TotoroTron/ANC_System/sources_1/new/i2s_controller.v

`timescale 1ns / 1ps
`default_nettype none
//////////////////////////////////////////////////////////////////////////////////
// Company: Digilent
// Engineer: Arthur Brown
// 
// Create Date: 03/23/2018 01:23:15 PM
// Module Name: axis_volume_controller
// Description: AXI-Stream volume controller intended for use with AXI Stream Pmod I2S2 controller.
//              Whenever a 2-word packet is received on the slave interface, it is multiplied by 
//              the value of the switches, taken to represent the range 0.0:1.0, then sent over the
//              master interface. Reception of data on the slave interface is halted while processing and
//              transfer is taking place.
// 
// Revision:
// Revision 0.01 - File Created
// Additional Comments:
// 
//////////////////////////////////////////////////////////////////////////////////

module i2s_controller (
    input wire clk,
    
    //AXIS SLAVE INTERFACE
    input  wire s_axis_valid,
    output reg  s_axis_ready = 1'b1,
    input  wire s_axis_last,
    
    // AXIS MASTER INTERFACE
    output reg m_axis_valid = 1'b0,
    input  wire m_axis_ready,
    output reg m_axis_last = 1'b0
);
    
    wire m_select = m_axis_last;
    wire m_new_word = (m_axis_valid == 1'b1 && m_axis_ready == 1'b1) ? 1'b1 : 1'b0;
    wire m_new_packet = (m_new_word == 1'b1 && m_axis_last == 1'b1) ? 1'b1 : 1'b0;
    
    wire s_select = s_axis_last;
    wire s_new_word = (s_axis_valid == 1'b1 && s_axis_ready == 1'b1) ? 1'b1 : 1'b0;
    wire s_new_packet = (s_new_word == 1'b1 && s_axis_last == 1'b1) ? 1'b1 : 1'b0;
    reg s_new_packet_r = 1'b0;
    
    always@(posedge clk) begin
        s_new_packet_r <= s_new_packet;
    end

    always@(posedge clk)
        if (s_new_packet_r == 1'b1)
            m_axis_valid <= 1'b1;
        else if (m_new_packet == 1'b1)
            m_axis_valid <= 1'b0;
            
    always@(posedge clk)
        if (m_new_packet == 1'b1)
            m_axis_last <= 1'b0;
        else if (m_new_word == 1'b1)
            m_axis_last <= 1'b1;
            
    always@(posedge clk)
        if (s_new_packet == 1'b1)
            s_axis_ready <= 1'b0;
        else if (m_new_packet == 1'b1)
            s_axis_ready <= 1'b1;
endmodule
