TotoroTron/ANC_System/sources_1/new/fsm_discrete_fir_filter.vhd

Library xpm;
use xpm.vcomponents.all;

LIBRARY IEEE;
USE IEEE.std_logic_1164.ALL;
USE IEEE.numeric_std.ALL;
USE work.anc_package.ALL;
use IEEE.NUMERIC_STD.ALL;

ENTITY Discrete_FIR_Filter_FSM IS
	GENERIC( L : integer := 128; W : integer := 8); -- L = length (filter order), W = width (parallel MACs)
	PORT(
		clk_anc 	: IN  std_logic; --10Khz ANC System Clock
		clk_dsp		: IN  std_logic; --125Mhz FPGA Clock Pin
		clk_ila     : in std_logic;
		reset 		: IN  std_logic;
        en   		: IN  std_logic;
        input 		: IN  std_logic_vector(23 DOWNTO 0); 
		output 		: out std_logic_vector(23 downto 0) := (others => '0');
		--RAM INTERFACE
		wt_addr 	: out std_logic_vector(5 downto 0) := (others => '0');
		wt_ram_en 	: out std_logic := '0';
		wt_wr_en	: out std_logic := '0';
		wt_data_in 	: in  vector_of_std_logic_vector24(0 to W-1)
	);
END Discrete_FIR_Filter_FSM;

ARCHITECTURE Behavioral OF Discrete_FIR_Filter_FSM IS
	CONSTANT R : integer := L/W; --length/width ratio
	TYPE STATE_TYPE IS (S0, S1, S2, S3, S4, R0, R1);
	SIGNAL STATE               : STATE_TYPE := S0;
	SIGNAL NEXT_STATE 	       : STATE_TYPE;
	SIGNAL input_signed 	   : signed(23 downto 0) := (others => '0');
	SIGNAL s_addr			   : unsigned(5 downto 0) := (others => '0');
	signal s_next_addr         : unsigned(5 downto 0) := (others => '0');
	SIGNAL idle                : std_logic := '1';
	signal next_idle           : std_logic := '1';
	signal s_sum               : signed(52 downto 0) := (others => '0');
	signal s_next_sum          : signed(52 downto 0) := (others => '0');
	
    signal sample_reg           : vector_of_signed24(0 to W-1) := (others => (others => '0'));
    signal next_sample_reg      : vector_of_signed24(0 to W-1) := (others => (others => '0'));
    signal sa_addr 		        :  std_logic_vector(5 downto 0) := (others => '0');
    signal sa_ram_en		    :  std_logic := '0'; --ram clk enable
    signal sa_wr_en 		    :  std_logic_vector(0 downto 0) := "0"; --ram write enable
    signal sa_data_in           : vector_of_std_logic_vector24(0 to W-1) := (others => (others => '0'));
    signal sa_data_out          : vector_of_std_logic_vector24(0 to W-1) := (others => (others => '0'));
    
    signal dbiterra 		: 	std_logic := '0';
	signal sbiterra 		:	std_logic := '0';
	signal ena 				:	std_logic := '0';
	signal injectdbiterra	:	std_logic := '0';
	signal injectsbiterra 	:	std_logic := '0';
	signal regcea 			:	std_logic := '0';
	signal sleep 			:	std_logic := '0';
	
	signal ila_addr : std_logic_vector(23 downto 0);
BEGIN

	input_signed <= signed(input);
	wt_addr <= std_logic_vector(s_addr);
	sa_addr <= std_logic_vector(s_addr);
	ila_addr <= X"0000" & "00" & sa_addr;
	
--    ILA_FIR_FILTER : ila_3
--	port map(
--	   clk => clk_dsp,
--	   probe0 => ila_addr,
--	   probe1 => wt_data_in(0),
--	   probe2 => wt_data_in(1),
--	   probe3 => wt_data_in(2),
--	   probe4 => sa_data_in(0),
--	   probe5 => sa_data_in(1),
--	   probe6 => sa_data_in(2)
--	);

	DSP_STATE_REGISTER : PROCESS(clk_dsp, reset, en)
	BEGIN
	IF rising_edge(clk_dsp) THEN
		IF reset = '1' THEN
			STATE <= R0;
			idle <= '1';
			s_addr <= (others => '0');
			sample_reg <= (others => (others => '0'));
		ELSIF en = '1' THEN
			STATE <= NEXT_STATE;
			idle <= next_idle;
			s_addr <= s_next_addr;
			s_sum <= s_next_sum;
			sample_reg <= next_sample_reg;
		END IF;
	END IF;
	END PROCESS;
	
    DSP_STATE_MACHINE : PROCESS(STATE, clk_anc, idle, s_addr, wt_data_in, input_signed, sample_reg)
        variable weight_in 	    : vector_of_signed24(0 to W-1) := (others => (others => '0'));
        variable sample_in      : vector_of_signed24(0 to W-1) := (others => (others => '0'));
        variable sample_out     : vector_of_signed24(0 to W-1) := (others => (others => '0'));
        variable mult			: vector_of_signed48(0 to W-1) := (others => (others => '0'));
        variable mult_cast	    : vector_of_signed53(0 to W-1) := (others => (others => '0'));
        variable mux1_out       : vector_of_signed24(0 to W-1) := (others => (others => '0'));
        variable mux2_out       : vector_of_signed24(0 to W-1) := (others => (others => '0'));
        variable accumulator	: signed(52 downto 0) := (others => '0');
    BEGIN
        next_idle       <= idle;
        s_next_addr     <= s_addr;
        s_next_sum      <= s_sum;
        next_sample_reg <= sample_reg;
        weight_in       := (others => (others => '0'));
        mult            := (others => (others => '0'));
        mult_cast       := (others => (others => '0'));
        accumulator     := (others => '0');
        sample_in       := (others => (others => '0'));
        sample_out      := (others => (others => '0'));
        mux1_out        := (others => (others => '0'));
        mux2_out        := (others => (others => '0'));
        
        CASE STATE IS
        WHEN S0 => --initial state
            wt_ram_en <= '0'; wt_wr_en <= '0';
            sa_ram_en <= '0'; sa_wr_en <= "0"; 
            s_next_addr <= (others => '0');
            NEXT_STATE <= S0;
            IF CLK_ANC = '1' THEN
                NEXT_IDLE <= '1';
            ELSIF CLK_ANC = '0' AND IDLE = '1' THEN
                s_next_sum <= (others => '0');
                NEXT_IDLE <= '0';
                NEXT_STATE <= S1;
            END IF; 
        WHEN S1 => --initiate read from memory (read latency = 1)
            wt_ram_en <= '1'; wt_wr_en <= '0';
            sa_ram_en <= '1'; sa_wr_en <= "0"; 
            NEXT_STATE <= S2; --S2
        WHEN S2 => --wait for read latency
            wt_ram_en <= '0'; wt_wr_en <= '0';
            sa_ram_en <= '0'; sa_wr_en <= "0"; 
            NEXT_STATE <= S3;
        WHEN S3 => --data from memory clocked-in
            wt_ram_en <= '0'; wt_wr_en <= '0';
            sa_ram_en <= '1'; sa_wr_en <= "1"; 
            accumulator := s_sum;
            
            for i in 0 to W-1 loop
                weight_in(i) := signed(wt_data_in(i));
                sample_in(i) := signed(sa_data_in(i));
                
                if i = 0 then
                    if s_addr = 0 then
                    mux1_out(i) := input_signed; else
                    mux1_out(i) := sample_in(i); end if;
                else
                    if s_addr = R-1 then
                    mux1_out(i) := sample_reg(i-1); else
                    mux1_out(i) := sample_in(i); end if;
                end if;
                
                next_sample_reg(i) <= mux1_out(i);
                sample_out(i) := sample_reg(i);
                sa_data_out(i) <= std_logic_vector(sample_out(i)(23 downto 0));
                
                if i = 0 then
                    if s_addr = 0 then
                    mux2_out(i) := input_signed; else
                    mux2_out(i) := sample_in(i); end if;
                else
                    mux2_out(i) := sample_in(i);
                end if;
                
                mult(i) := weight_in(i) * mux2_out(i);
                mult_cast(i) := resize(mult(i), 53);
                accumulator := accumulator + mult_cast(i); --cascading adder risks timing failure
            end loop; --find a way to for-loop a balanced adder tree

            s_next_sum <= accumulator;
            
            NEXT_STATE <= S4;
        WHEN S4 => --increment address
            wt_ram_en <= '0'; wt_wr_en <= '0';
            sa_ram_en <= '0'; sa_wr_en <= "0"; 
            IF s_addr < R-1 THEN
                s_next_addr <= s_addr + 1;
                NEXT_STATE <= S1;
            ELSIF s_addr = R-1 THEN
                output <= std_logic_vector(s_sum(47 downto 24));
                NEXT_STATE <= S0;
            END IF;
        WHEN R0 => --flush RAM with zeros
            wt_ram_en <= '0'; wt_wr_en <= '0';
            sa_ram_en <= '1'; sa_wr_en <= "1"; 
            sa_data_out <= (others => (others => '0'));
            output <= (others => '0');
            NEXT_STATE <= R1;
        WHEN R1 =>
            wt_ram_en <= '0'; wt_wr_en <= '0';
            sa_ram_en <= '0'; sa_wr_en <= "0"; 
            IF s_addr < R-1 THEN
                s_next_addr <= s_addr + 1;
                NEXT_STATE <= R0;
            ELSIF s_addr = R-1 THEN
                NEXT_STATE <= S0;
            END IF;
        END CASE;
        
    END PROCESS;
    
    -- xpm_memory_spram: Single Port RAM
    -- Xilinx Parameterized Macro, version 2019.2
    INPUT_BUFFER_STORAGE : for i in 0 to W-1 generate
    xpm_memory_spram_inst0 : xpm_memory_spram
        generic map (
        ADDR_WIDTH_A => 6, -- DECIMAL
        AUTO_SLEEP_TIME => 0, -- DECIMAL
        BYTE_WRITE_WIDTH_A => 24, -- DECIMAL
        CASCADE_HEIGHT => 0, -- DECIMAL
        ECC_MODE => "no_ecc", -- String
        MEMORY_INIT_FILE => "none", -- String
        MEMORY_INIT_PARAM => "0", -- String
        MEMORY_OPTIMIZATION => "true", -- String
        MEMORY_PRIMITIVE => "auto", -- String
        MEMORY_SIZE => 1536, -- DECIMAL
        MESSAGE_CONTROL => 0, -- DECIMAL
        READ_DATA_WIDTH_A => 24, -- DECIMAL
        READ_LATENCY_A => 1, -- DECIMAL
        READ_RESET_VALUE_A => "0", -- String
        RST_MODE_A => "SYNC", -- String
        SIM_ASSERT_CHK => 0, -- DECIMAL; 0=disable simulation messages, 1=enable simulation messages
        USE_MEM_INIT => 1, -- DECIMAL
        WAKEUP_TIME => "disable_sleep", -- String
        WRITE_DATA_WIDTH_A => 24, -- DECIMAL
        WRITE_MODE_A => "read_first" -- String
    )
    port map (
        dbiterra => dbiterra,
        douta => sa_data_in(i),
        sbiterra => sbiterra,
        addra => sa_addr,
        clka => clk_dsp,
        dina => sa_data_out(i),
        ena => sa_ram_en,
        injectdbiterra => injectdbiterra,
        injectsbiterra => injectsbiterra,
        regcea => regcea,
        rsta => reset,
        sleep => sleep,
        wea => sa_wr_en
        );
    end generate;
    
END ARCHITECTURE;
