TotoroTron/ANC_System/sources_1/new/fsm_primary_path.vhd

LIBRARY IEEE;
USE IEEE.std_logic_1164.ALL;
USE IEEE.numeric_std.ALL;
USE work.anc_package.ALL;

Library xpm;
use xpm.vcomponents.all;

entity primary_path is
    GENERIC( L : integer; W : integer; leak_en : std_logic); --length, width
	port(
		clk_anc 	: in std_logic;
		clk_dsp 	: in std_logic;
		clk_ila     : in std_logic;
		reset 		: in std_logic;
		
		filt_enable : in std_logic;
		filt_input 	: in std_logic_vector(23 downto 0);
		filt_output : out std_logic_vector(23 downto 0);
		algo_enable : in std_logic;
		algo_input 	: in std_logic_vector(23 downto 0);
		algo_error 	: in std_logic_vector(23 downto 0);
		algo_adapt 	: in std_logic
	);
end entity primary_path;

architecture rtl of primary_path is
	CONSTANT R : integer := L/W; --length/width ratio
	signal dbiterra 		: 	std_logic := '0';
	signal dbiterrb			:	std_logic := '0';
	signal douta 			:	vector_of_std_logic_vector24(0 to W-1) := (others => (others => '0'));
	signal doutb 			:	vector_of_std_logic_vector24(0 to W-1) := (others => (others => '0'));
	signal sbiterra 		:	std_logic := '0';
	signal sbiterrb 		:	std_logic := '0';
	signal addra 			:	std_logic_vector(5 downto 0) := (others => '0');
	signal addrb 			:	std_logic_vector(5 downto 0) := (others => '0');
	signal dina 			:	vector_of_std_logic_vector24(0 to W-1) := (others => (others => '0'));
	signal dinb 			:	vector_of_std_logic_vector24(0 to W-1) := (others => (others => '0'));
	signal ena 				:	std_logic := '0';
	signal enb 				:	std_logic := '0';
	signal injectdbiterra	:	std_logic := '0';
	signal injectdbiterrb 	:	std_logic := '0';
	signal injectsbiterra 	:	std_logic := '0';
	signal injectsbiterrb 	:	std_logic := '0';
	signal regcea 			:	std_logic := '0';
	signal regceb 			:	std_logic := '0';
	signal sleep 			:	std_logic := '0';
	signal wea 				:	std_logic_vector(0 downto 0) := "0";
	signal web 				:	std_logic_vector(0 downto 0) := "0";
begin

LMS_UPDATE : entity work.LMS_Update_FSM
generic map(L => L, W => W, leak_en => leak_en)
port map(
	clk_anc 	=> clk_anc,
	clk_dsp 	=> clk_dsp,
	clk_ila     => clk_ila,
	reset 		=> reset,
	en			=> algo_enable,
	input		=> algo_input,
	error		=> algo_error,
	adapt		=> algo_adapt,
	--ram interface
	wt_addr		=> addra,
	wt_ram_en	=> ena,
	wt_wr_en	=> wea(0),
	wt_data_in	=> douta,
	wt_data_out	=> dina
);

FIR_FILTER : entity work.Discrete_FIR_Filter_FSM
generic map(L => L, W => W)
port map(
	clk_anc 	=> clk_anc,
	clk_dsp 	=> clk_dsp,
	clk_ila     => clk_ila,
	reset 		=> reset,
	en			=> filt_enable,
	input		=> filt_input,
	output		=> filt_output,
	--ram interface
	wt_addr		=> addrb,
	wt_ram_en	=> enb,
	wt_wr_en	=> web(0),
	wt_data_in	=> doutb
);

-- xpm_memory_tdpram: True Dual Port RAM
-- Xilinx Parameterized Macro, version 2019.2
GEN_WEIGHTS_STORAGE : for i in 0 to W-1 generate
    WEIGHTS_STORAGE : xpm_memory_tdpram
    generic map (
        ADDR_WIDTH_A => 6, -- DECIMAL
        ADDR_WIDTH_B => 6, -- DECIMAL
        AUTO_SLEEP_TIME => 0, -- DECIMAL
        BYTE_WRITE_WIDTH_A => 24, -- DECIMAL
        BYTE_WRITE_WIDTH_B => 24, -- DECIMAL
        CASCADE_HEIGHT => 0, -- DECIMAL
        CLOCKING_MODE => "common_clock", -- String
        ECC_MODE => "no_ecc", -- String
        MEMORY_INIT_FILE => "none", -- String
        MEMORY_INIT_PARAM => "0", -- String
        MEMORY_OPTIMIZATION => "true", -- String
        MEMORY_PRIMITIVE => "auto", -- String
        MEMORY_SIZE => 1536, -- DECIMAL (measured in bits)
        MESSAGE_CONTROL => 0, -- DECIMAL
        READ_DATA_WIDTH_A => 24, -- DECIMAL
        READ_DATA_WIDTH_B => 24, -- DECIMAL
        READ_LATENCY_A => 1, -- DECIMAL
        READ_LATENCY_B => 1, -- DECIMAL
        READ_RESET_VALUE_A => "0", -- String
        READ_RESET_VALUE_B => "0", -- String
        RST_MODE_A => "SYNC", -- String
        RST_MODE_B => "SYNC", -- String
        SIM_ASSERT_CHK => 0, -- DECIMAL; 0=disable simulation messages, 1=enable simulation messages
        USE_EMBEDDED_CONSTRAINT => 0, -- DECIMAL
        USE_MEM_INIT => 1, -- DECIMAL
        WAKEUP_TIME => "disable_sleep", -- String
        WRITE_DATA_WIDTH_A => 24, -- DECIMAL
        WRITE_DATA_WIDTH_B => 24, -- DECIMAL
        WRITE_MODE_A => "no_change", -- String
        WRITE_MODE_B => "no_change" -- String
    ) port map (
        dbiterra => dbiterra, --unused
        dbiterrb => dbiterrb, --unused
        douta => douta(i),
        doutb => doutb(i),
        sbiterra => sbiterra, --unused
        sbiterrb => sbiterrb, --unused
        addra => addra,
        addrb => addrb,
        clka => clk_dsp,
        clkb => clk_dsp,
        dina => dina(i),
        dinb => dinb(i), --unused
        ena => ena,
        enb => enb,
        injectdbiterra => injectdbiterra, --unused
        injectdbiterrb => injectdbiterrb, --unused
        injectsbiterra => injectsbiterra, --unused
        injectsbiterrb => injectsbiterrb, --unused
        regcea => regcea, --unused
        regceb => regceb, --unused
        rsta => reset,
        rstb => reset,
        sleep => sleep, --unused
        wea => wea,
        web => web
    );
    -- End of xpm_memory_tdpram_inst instantiation
end generate;
end architecture;
