TotoroTron/ANC_System/sources_1/ip/clk_wiz_0/clk_wiz_0_stub.v

// Copyright 1986-2020 Xilinx, Inc. All Rights Reserved.
// --------------------------------------------------------------------------------
// Tool Version: Vivado v.2020.1 (win64) Build 2902540 Wed May 27 19:54:49 MDT 2020
// Date        : Sun Dec 13 15:02:36 2020
// Host        : DESKTOP-2V0TF99 running 64-bit major release  (build 9200)
// Command     : write_verilog -force -mode synth_stub -rename_top clk_wiz_0 -prefix
//               clk_wiz_0_ clk_wiz_0_stub.v
// Design      : clk_wiz_0
// Purpose     : Stub declaration of top-level module interface
// Device      : xc7z020clg400-1
// --------------------------------------------------------------------------------

// This empty module with port declaration file causes synthesis tools to infer a black box for IP.
// The synthesis directives are for Synopsys Synplify support to prevent IO buffer insertion.
// Please paste the declaration into a Verilog source file or add the file as an additional source.
module clk_wiz_0(clk_out1, clk_in1)
/* synthesis syn_black_box black_box_pad_pin="clk_out1,clk_in1" */;
  output clk_out1;
  input clk_in1;
endmodule
