TotoroTron/ANC_System/sources_1/ip/ila_3/ila_3_stub.v

// Copyright 1986-2020 Xilinx, Inc. All Rights Reserved.
// --------------------------------------------------------------------------------
// Tool Version: Vivado v.2020.1 (win64) Build 2902540 Wed May 27 19:54:49 MDT 2020
// Date        : Mon Dec 21 21:22:15 2020
// Host        : DESKTOP-2V0TF99 running 64-bit major release  (build 9200)
// Command     : write_verilog -force -mode synth_stub
//               c:/Vivado_Projects/ANC_System/ANC_System.srcs/sources_1/ip/ila_3/ila_3_stub.v
// Design      : ila_3
// Purpose     : Stub declaration of top-level module interface
// Device      : xc7z020clg400-1
// --------------------------------------------------------------------------------

// This empty module with port declaration file causes synthesis tools to infer a black box for IP.
// The synthesis directives are for Synopsys Synplify support to prevent IO buffer insertion.
// Please paste the declaration into a Verilog source file or add the file as an additional source.
(* x_core_info = "ila,Vivado 2020.1" *)
module ila_3(clk, probe0, probe1, probe2, probe3, probe4, probe5, 
  probe6, probe7, probe8, probe9, probe10, probe11, probe12, probe13, probe14, probe15)
/* synthesis syn_black_box black_box_pad_pin="clk,probe0[23:0],probe1[23:0],probe2[23:0],probe3[23:0],probe4[23:0],probe5[23:0],probe6[23:0],probe7[23:0],probe8[0:0],probe9[0:0],probe10[0:0],probe11[0:0],probe12[0:0],probe13[0:0],probe14[0:0],probe15[0:0]" */;
  input clk;
  input [23:0]probe0;
  input [23:0]probe1;
  input [23:0]probe2;
  input [23:0]probe3;
  input [23:0]probe4;
  input [23:0]probe5;
  input [23:0]probe6;
  input [23:0]probe7;
  input [0:0]probe8;
  input [0:0]probe9;
  input [0:0]probe10;
  input [0:0]probe11;
  input [0:0]probe12;
  input [0:0]probe13;
  input [0:0]probe14;
  input [0:0]probe15;
endmodule
