TotoroTron/ANC_System/(commit log)

2020-10-19 replaced top_level
    new top_level will instantiate ANC_system and pmod_i2s2 driver
    [ANC_System.vhd, top_level.vhd]
2020-10-19 generated schematic for module ANC_System
2020-10-19 small fix to ANC_System
    wired signal AntiNoiseAdapt to output antiNoise
    [ANC_System.vhd]
2020-10-20 added pmod_i2s2 module with testbench
    pmod_i2s2 is the ADC/DAC interface for the FPGA
2020-10-22 added random signal generator
    will be used for LMS filter training
2020-10-24 fixing minor errors during implementation
    [axis_i2s2.v, constraints.xdc]
2020-10-27 beginning switch from fixdt(1,24,0) to fixdt(1,24,24)
    [ANC_System.vhd, LMS_testbench.vhd, anc_testbench.vhd, constraints.xdc, fir_testbench.vhd, lmsUpdate_testbench.vhd, rand_testbench.vhd]
2020-10-29 replaced when-assign statements with clocked if-statements
    [ANC_System.vhd, anc_testbench.vhd]
2020-11-03 expanded ILA to have 12 24-bit ports to probe filter weights
2020-11-05 inspecting integrated logic analyzer
    trial 1
    analog devices
2020-11-07 fixed top_level wiring of microphones to anc_system
    [ANC_System.vhd, top_level.vhd]
2020-11-08 transformed asynchronous reset to synchronous reset in sine_generator
    [ANC_System.vhd, rand_generator.vhd, top_level.vhd]
2020-11-15 increased number of taps for LMS Update and ANC Filter from 12 to 32
2020-11-16 reduced ANC sample rate from 44Khz to 7Khz
2020-11-19 Major Changes (description) achieved -12.6dB attenuation
    Achieved -12.6 dB of attenuation.
    Decreased ANC sample rate to 10KHz.
    Increased length of AF and SP Filters from 12 to 24.
    Decreased length of ANC Filters from 32 to 12.
    Testbenches are still out of date.
    ANC_System samples at 10KHz but the adc/dacs sample at 44.1Khz - this is currently causing jitter in the sound output
    [iladata_latency_antinoise.csv, iladata_latency_noise.csv, iladata_wanc1.csv, iladata_wanc2.csv, iladata_wanc3.csv, iladata_wanc4.csv, iladata_wanc5.csv]
2020-11-19 Reduced adc/dac sampling rate from 44.1Khz to 5.1Khz
    Eliminated wave jitter due to sample rate mismatch between ANC_System and dac/dac.
    Fixed some index bugs from the resizing of filters.
    Reduced amplitude of training noise.
    [ANC_System.vhd, clk_wiz_0.v, clk_wiz_0_clk_wiz.v, clk_wiz_0_sim_netlist.v, clk_wiz_0_sim_netlist.vhdl]
2020-11-19 Updated testbenches, Added HDL-optimized FIR Filter vhd files (currently not used)
2020-11-21 synchronized ANC_SYSTEM clock with the JA_PMOD clock
    tied clk_anc with tx_lrck of JA_PMOD
    added csv files with filter weights data gathered from ILA.
    added more ILAs to gather more data during runs
    [iladata_latency_antinoise.csv, iladata_latency_noise.csv, iladata_wanc1.csv, iladata_wanc2.csv, iladata_wanc3.csv, iladata_wanc4.csv, iladata_wanc5.csv, latency_antinoise.csv]
2020-11-22 removed xlsx and csv spreadsheets
    [waf1.csv, waf1.xlsx, waf2.csv, wanc1.csv, wanc1.xlsx, wanc2.csv, wsp1.csv, wsp1.xlsx]
2020-12-02 beginning pipelined version of LMS_Update (currently not simulating correctly)
    [ANC_System.vhd, LMSU_testbench.vhd, clk_wiz_0_sim_netlist.v, clk_wiz_0_sim_netlist.vhdl, clk_wiz_0_stub.v, clk_wiz_0_stub.vhdl]
2020-12-04 pipelined version of LMS_Update working correctly in simulation
    beginning pipelined version of FIR Filters
    [ANC_System.vhd, lmsUpdate_testbench.vhd]
2020-12-04 pipelined fir_filter simulating correctly. integrated pipelined parts into anc_system, not working on hardware (no attenuation)
    [ANC_System.vhd, fir_testbench.vhd, lmsUpdate_testbench.vhd, top_level.vhd]
2020-12-05 minor changes, pipelined fir_filter NOT simulating correctly
    [ANC_System.vhd, fir_testbench.vhd, lmsUpdate_testbench.vhd]
2020-12-05 Created new ram-based models for FIR, LMS_filters, LMS_update using state-machine representation
    Using RAM blocks to store weight information instead of using large MUX's.
    Decided that state-machine representation is much easier to understand and troubleshoot.
    These new files are currently not instantiated in anc_system. Currently have not been tested.
2020-12-06 FIR_Filter_FSM now simulates correctly
    modified fir_testbench to instantiate both the Matlab-generated model and my new FSM model to compare behavior in simulation
    [LMSU_testbench.vhd, LMS_Update_FSM_testbench.vhd, fir_testbench.vhd, fsm_discrete_fir_filter.vhd, fsm_lms_update.vhd, fsm_primary_path.vhd, fsm_secondary_path.vhd]
2020-12-07 FSM_LMS_Filter now simulates correctly
    LMS_testbench simulation shows that the new FSM model produces same output as the Matlab-generated model
    [LMSU_testbench.vhd, LMS_testbench.vhd, fsm_discrete_fir_filter.vhd, fsm_lms_filter.vhd]
2020-12-07 new FSM LMS_Update model now simulates correctly
    fixed some data_valid timing in FSM LMS_Filter
    [fsm_discrete_fir_filter.vhd, fsm_lms_filter.vhd, fsm_lms_update.vhd, lmsUpdate_testbench.vhd]
2020-12-08 Remodelled ANC_System using the new FSM models, reconfigured clocks driving dac/adc's
    pulled the clock counter out of axis_i2s2 into the top level
2020-12-09 ANC_System now fully configured using new partially-pipelined FSM models
    Primary sound path: ANC Filter, LMS Update
    Secondary sound path: LMS Filter, SP Filter
    Acoustic Feedback sound path: LMS Filter, AF Filter.
    FSM Models now simulate correctly compared to Matlab-generated models.
    Developer can now specify "pipelineness" vs "paralellness" of the filters in the entity generics
    [ANC_System.vhd, LMS_testbench.vhd, axis_i2s2.v, fir_testbench.vhd, fsm_discrete_fir_filter.vhd, fsm_lms_filter.vhd, fsm_lms_update.vhd]
2020-12-11 code cleanup
    [latency_antinoise.csv, latency_noise.csv]
2020-12-12 Fixed state machine for FIR Filter
    state machine process is now sensitive to state, clk_anc, address, idle, data_in
    added next_<> signals for each signal that the state machine assigns
    behavior is now correct when probed with ILA
    [fsm_discrete_fir_filter.vhd]
2020-12-12 Fixed state machines for FIR, LMS Filter, LMS Update
    fixed sensitivity lists
    [LMS_Update_FSM_testbench.vhd, LMS_testbench.vhd, fir_testbench.vhd, fsm_discrete_fir_filter.vhd, fsm_lms_filter.vhd, fsm_lms_update.vhd, lmsUpdate_testbench.vhd]
2020-12-12 code cleanup, changed filter orders and step sizes
2020-12-12 Introduced leakage factor into LMS_Update and LMS_Filter
    reduced microphone gain from 4x to 2x.
    leakage factor currently flatlines filter outputs. experimenting with different leakage factors
    [LMS_testbench.vhd, fsm_lms_filter.vhd, fsm_lms_update.vhd, top_level.vhd]
2020-12-13 Fixed leakage factor bit select
    [LMS_testbench.vhd, fsm_lms_filter.vhd, fsm_lms_update.vhd]
2020-12-20 Discovered problem with RAM-based input-buffer
    For W>1, the input buffer does not behave correctly. the buffer does not update for when s_addr = 0 and skips a sample, resulting in output error
    [fsm_discrete_fir_filter.vhd]
2020-12-21 fixed input buffer problem for fir filter
    sa_data_out(i) <= sample_reg(i-1) when s_addr = R-1, NOT when s_addr = 0
    verified against hdl-coder model in testbench
    [fsm_discrete_fir_filter.vhd]
2020-12-21 corrected input buffer problem for fir filter, lms update, and lms filter
    all verified against respective hdl-coder generated models in testbench
    [LMS_Update_FSM_testbench.vhd, fir_testbench.vhd, fsm_discrete_fir_filter.vhd, fsm_lms_filter.vhd, fsm_lms_update.vhd]
2020-12-23 23 dB attenuation, overflow error
    overflow error occurs somewhere after attenuating 23dB
    changed leakage factor and step size
    [ANC_System.vhd, LMSU_testbench.vhd, LMS_testbench.vhd, fsm_discrete_fir_filter.vhd, fsm_lms_filter.vhd, fsm_lms_update.vhd]
2020-12-24 control unit, 20Mhz dsp clock, flush RAM routine
    created dedicated control unit to drive control signals in anc_system.
    dsp clock is now 20Mhz
    reset now flushes RAMs with zeros
    [ANC_System.vhd, LMS_Update_FSM_testbench.vhd, axis_i2s2.v, clk_wiz_0.v, clk_wiz_0_clk_wiz.v, clk_wiz_0_sim_netlist.v, clk_wiz_0_sim_netlist.vhdl, clk_wiz_0_stub.v]
